Zorban62/EpromEmulator/Hardware/Scheda 2.jpg

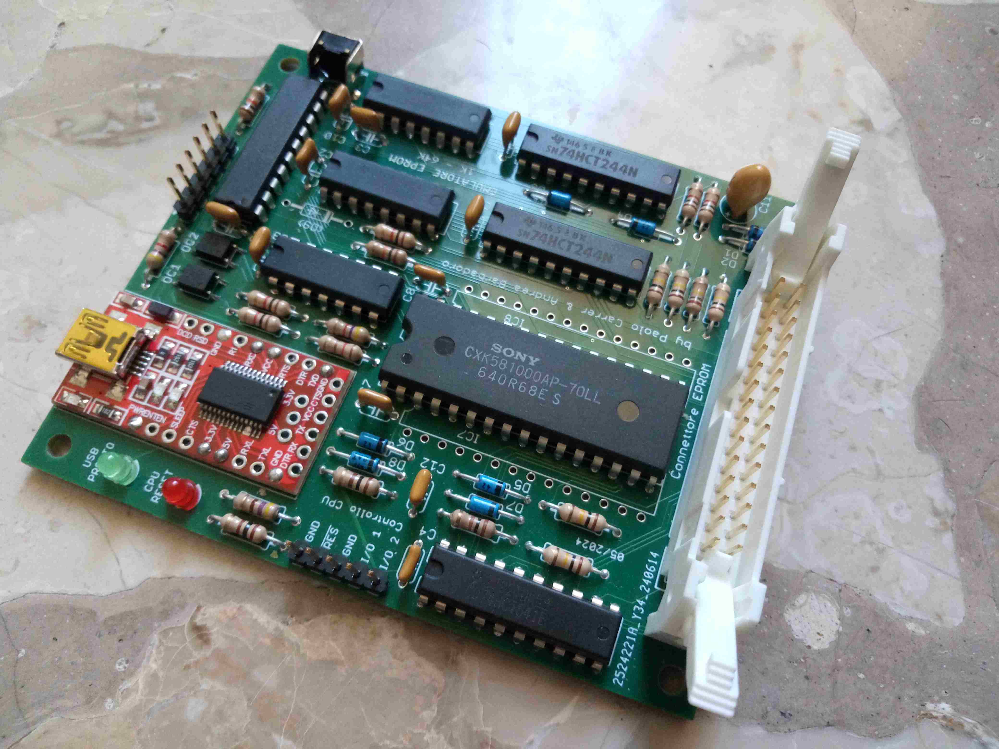
Hardware/Scheda 2.jpg
