Zorban62/EpromEmulator/Hardware/EMUL002.jpg

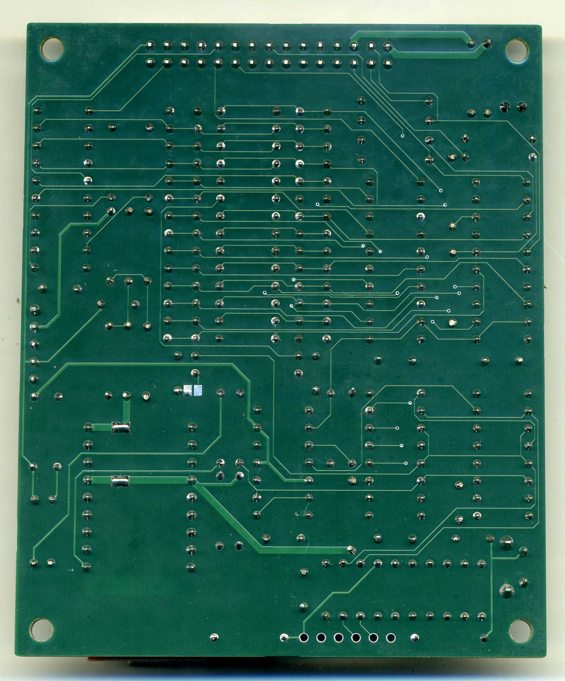
Hardware/EMUL002.jpg
