Zorban62/EpromEmulator/Hardware/Connettore crimpato filo Reset separato.jpg

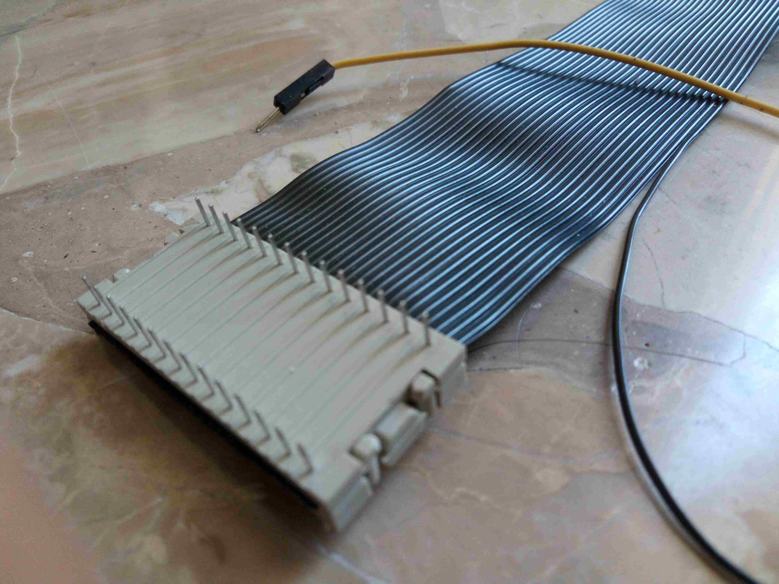
Hardware/Connettore crimpato filo Reset separato.jpg
