Zorban62/EpromEmulator/Hardware/Connettore DIL 28 pin.jpg

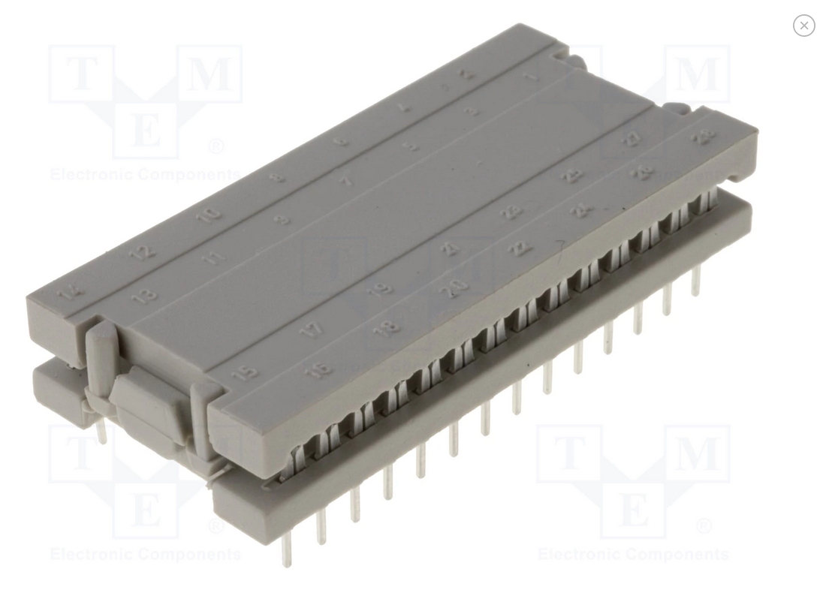
Hardware/Connettore DIL 28 pin.jpg
