Zorban62/EpromEmulator/Hardware/Connettore IDC 30 pin.jpg

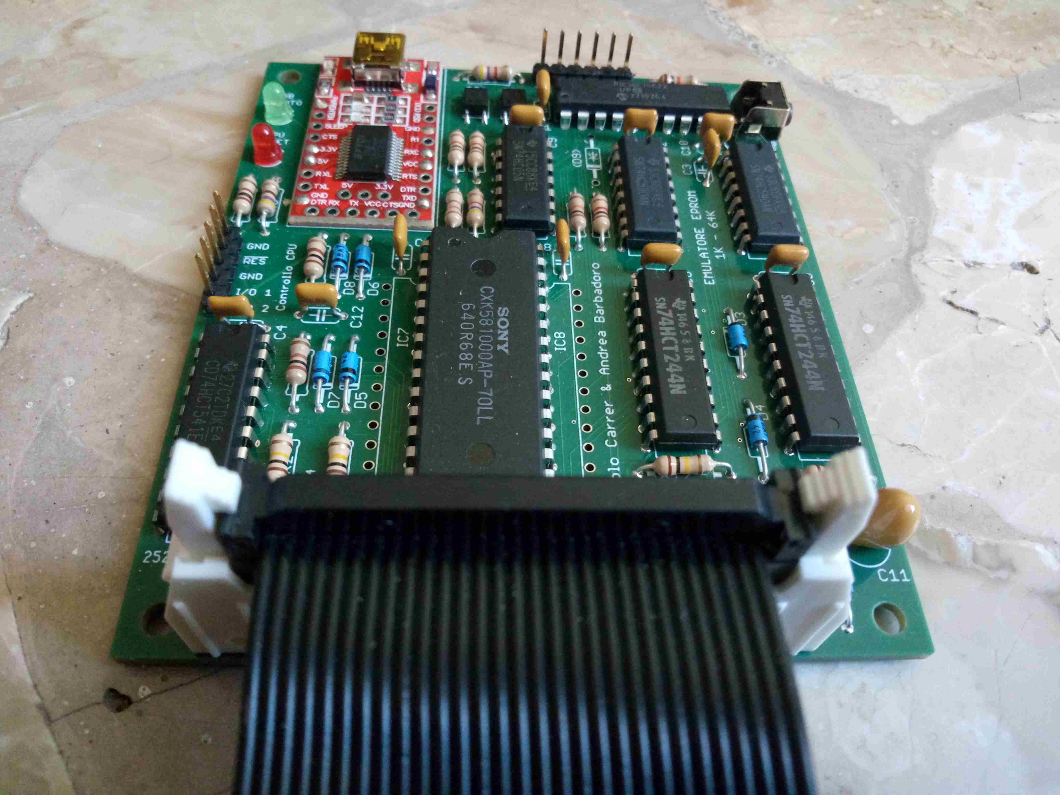
Hardware/Connettore IDC 30 pin.jpg
