Zorban62/EpromEmulator/Hardware/EMUL001.jpg

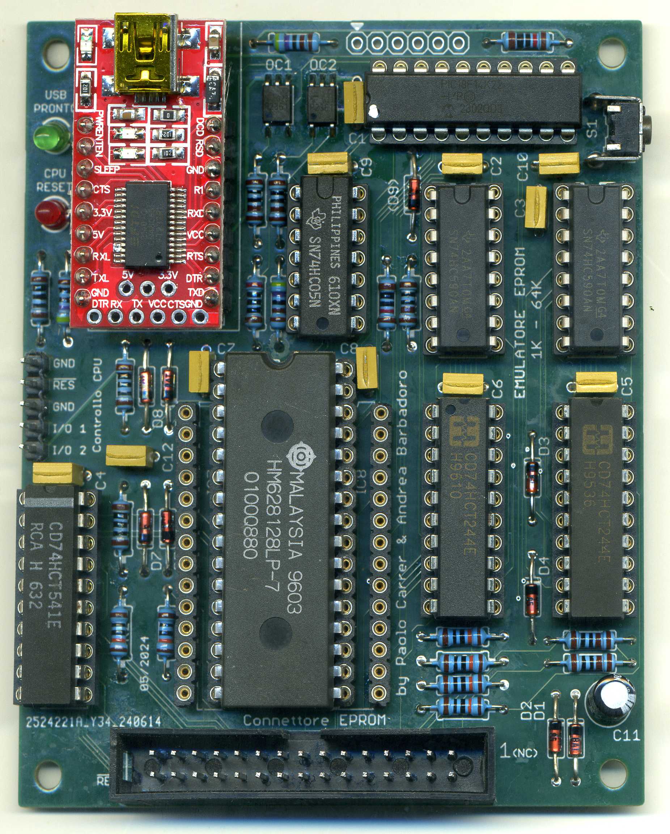
Hardware/EMUL001.jpg
