Zorban62/EpromEmulator/Hardware/PCB componenti.png

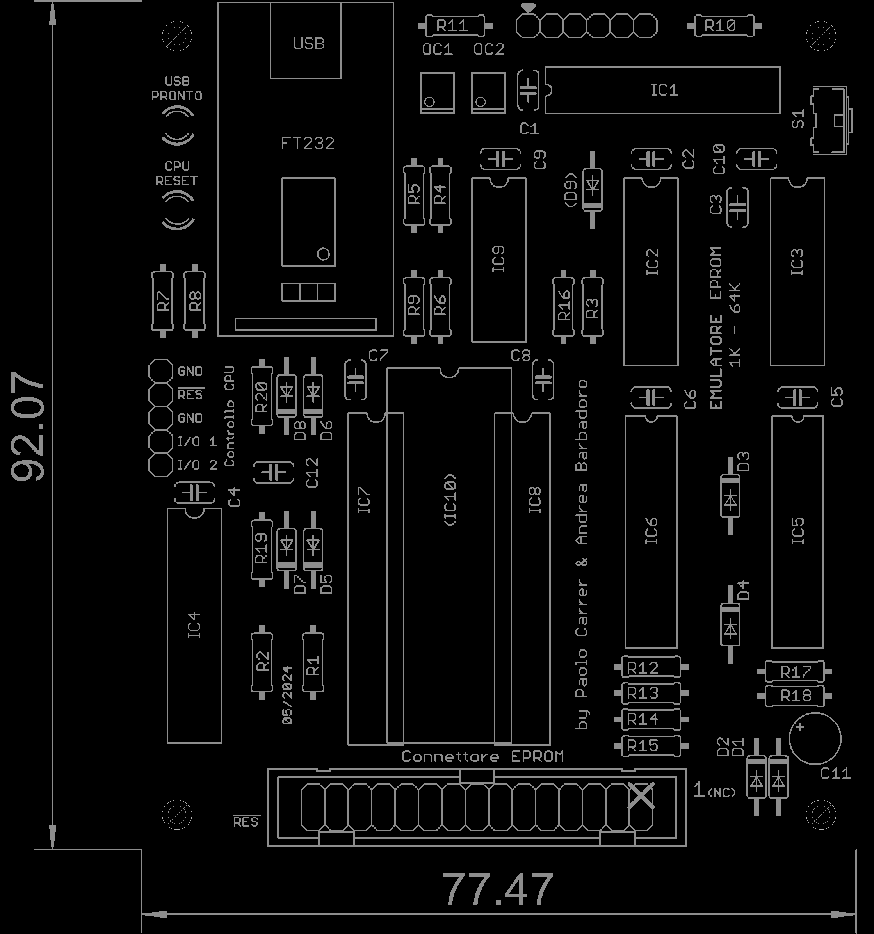
Hardware/PCB componenti.png
