Zorban62/EpromEmulator/Hardware/PCB rame BOTTOM.png

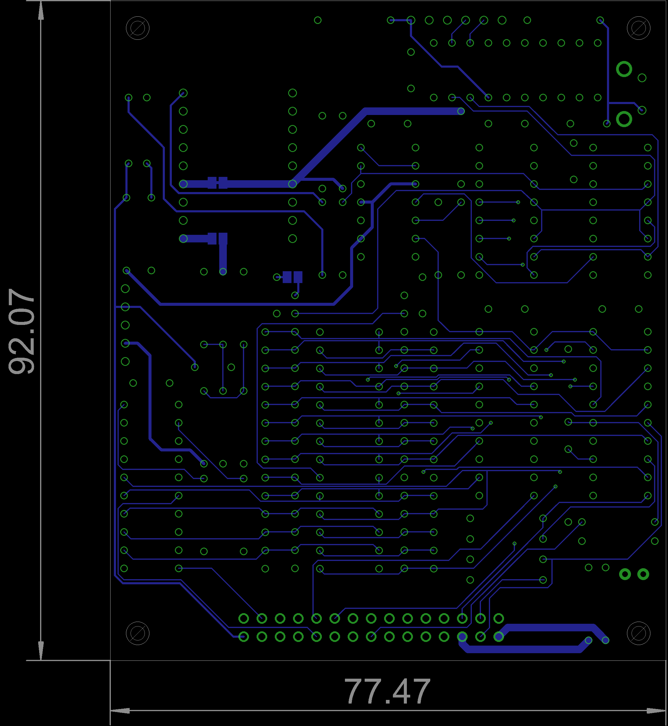
Hardware/PCB rame BOTTOM.png
