Zorban62/EpromEmulator/Hardware/PCB rame TOP.png

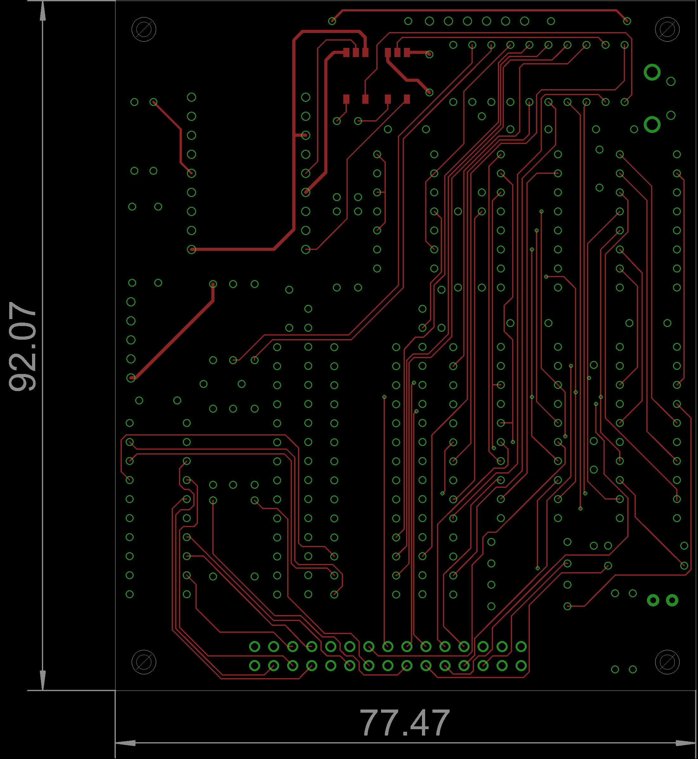
Hardware/PCB rame TOP.png
