Zorban62/EpromEmulator/Hardware/PCB valori.png

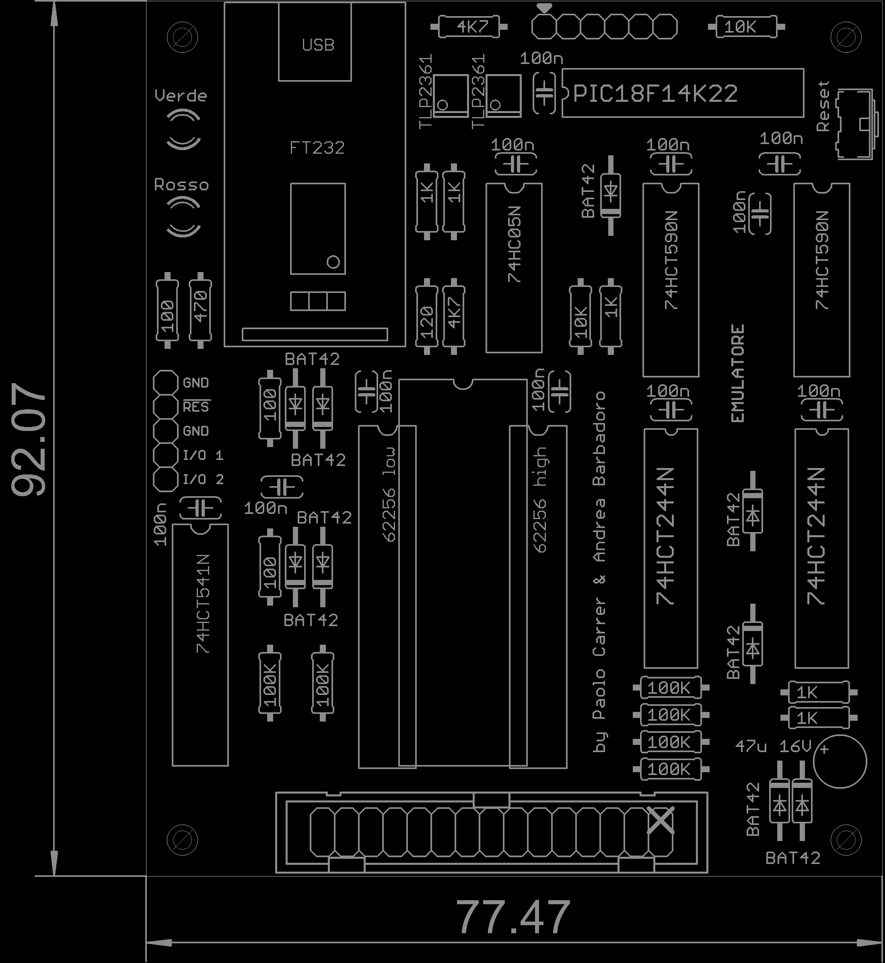
Hardware/PCB valori.png
