Zorban62/EpromEmulator/Hardware/schema 1.png

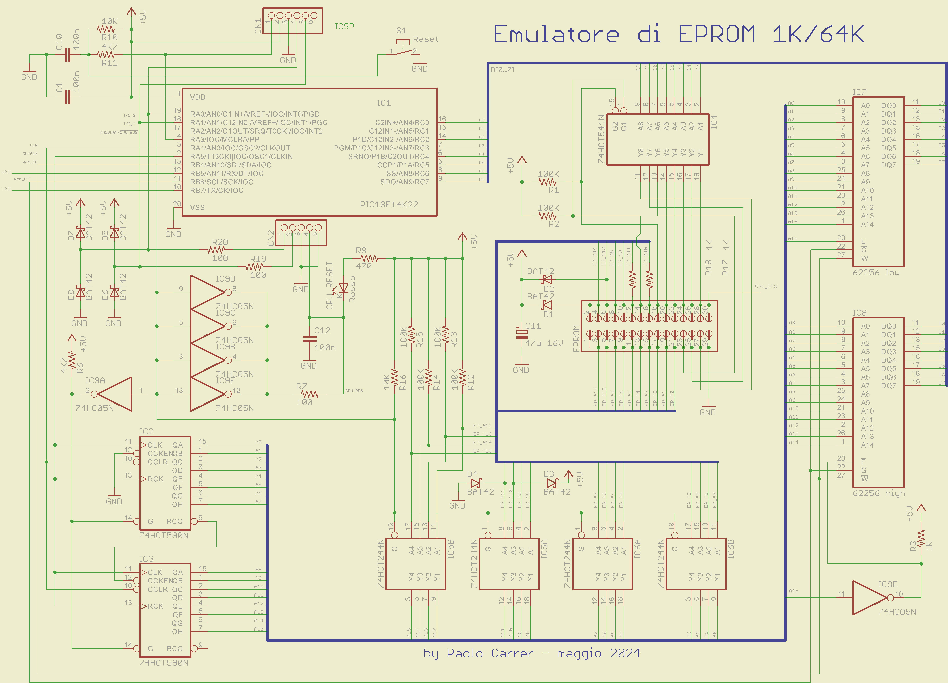
Hardware/schema 1.png
