Zorban62/EpromEmulator/Hardware/schema 2.png

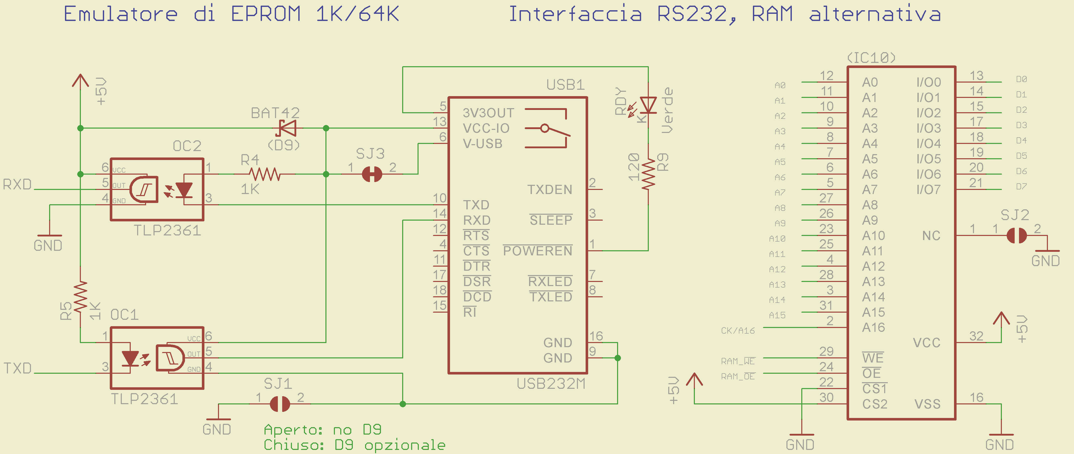
Hardware/schema 2.png
