Zorban62/EpromEmulator/Hardware/schema 3.png

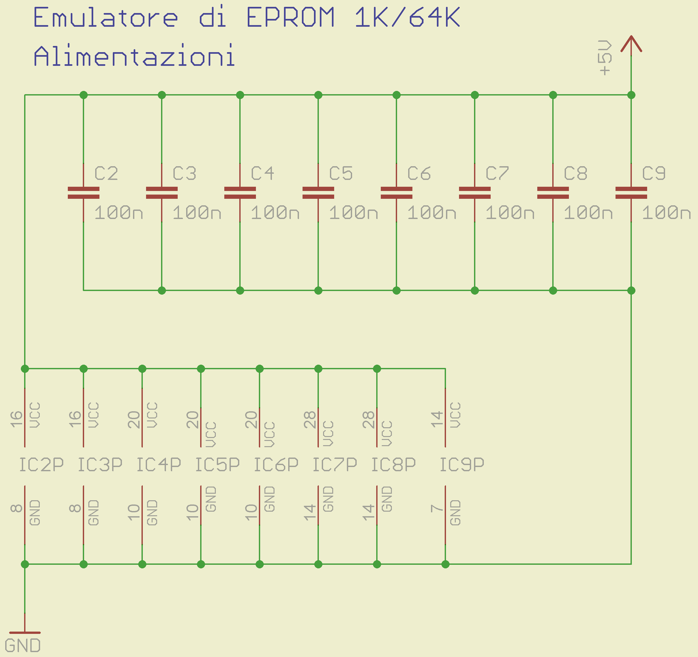
Hardware/schema 3.png
