Zorban62/EpromEmulator/Sorgenti Visual Studio/Parametri assembler.pdf

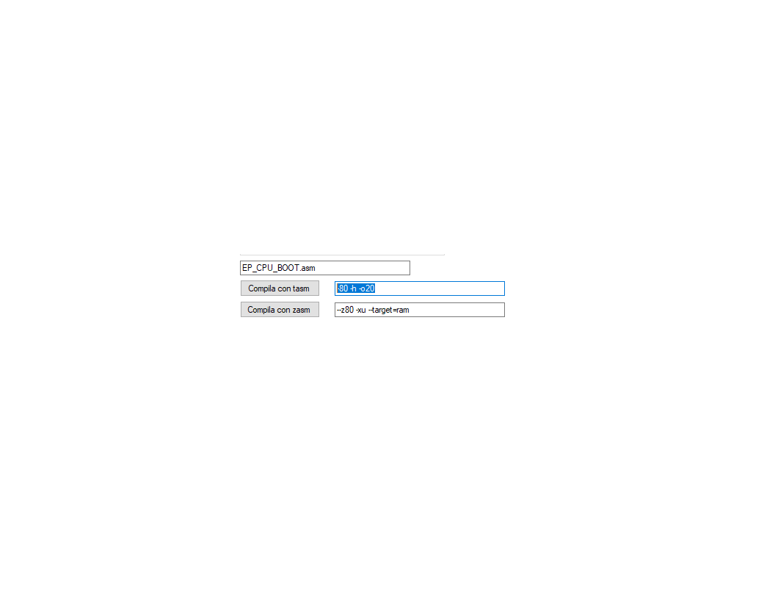
[picture p16: page 1]
