Zorban62/EpromEmulator/Firmware PIC/EEprom.asm

 
;******************************************************************************
; Banco EEPROM 0 padded
;******************************************************************************
                code    0xF00000

        de      0x01,0x02,0x03,0x00,0x00,0x00,0x00,0x00 ;00
        de      0x00,0x00,0x00,0x00,0x00,0x00,0x00,0x00 ;01
        de      0x00,0x00,0x00,0x00,0x00,0x00,0x00,0x00 ;02
        de      0x00,0x00,0x00,0x00,0x00,0x00,0x00,0x00 ;03
        de      0x00,0x00,0x00,0x00,0x00,0x00,0x00,0x00 ;04
        de      0x00,0x00,0x00,0x00,0x00,0x00,0x00,0x00 ;05
        de      0x00,0x00,0x00,0x00,0x00,0x00,0x00,0x00 ;06
        de      0x00,0x00,0x00,0x00,0x00,0x00,0x00,0x00 ;07
        de      0x00,0x00,0x00,0x00,0x00,0x00,0x00,0x00 ;08
        de      0x00,0x00,0x00,0x00,0x00,0x00,0x00,0x00 ;09
        de      0x00,0x00,0x00,0x00,0x00,0x00,0x00,0x00 ;0A
        de      0x00,0x00,0x00,0x00,0x00,0x00,0x00,0x00 ;0B
        de      0x00,0x00,0x00,0x00,0x00,0x00,0x00,0x00 ;0C
        de      0x00,0x00,0x00,0x00,0x00,0x00,0x00,0x00 ;0D
        de      0x00,0x00,0x00,0x00,0x00,0x00,0x00,0x00 ;0E
        de      0x00,0x00,0x00,0x00,0x00,0x00,0x00,0x00 ;0F
        de      0x00,0x00,0x00,0x00,0x00,0x00,0x00,0x00 ;10
        de      0x00,0x00,0x00,0x00,0x00,0x00,0x00,0x00 ;11
        de      0x00,0x00,0x00,0x00,0x00,0x00,0x00,0x00 ;12
        de      0x00,0x00,0x00,0x00,0x00,0x00,0x00,0x00 ;13
        de      0x00,0x00,0x00,0x00,0x00,0x00,0x00,0x00 ;14
        de      0x00,0x00,0x00,0x00,0x00,0x00,0x00,0x00 ;15
        de      0x00,0x00,0x00,0x00,0x00,0x00,0x00,0x00 ;16
        de      0x00,0x00,0x00,0x00,0x00,0x00,0x00,0x00 ;17
        de      0x00,0x00,0x00,0x00,0x00,0x00,0x00,0x00 ;18
        de      0x00,0x00,0x00,0x00,0x00,0x00,0x00,0x00 ;19
        de      0x00,0x00,0x00,0x00,0x00,0x00,0x00,0x00 ;1A
        de      0x00,0x00,0x00,0x00,0x00,0x00,0x00,0x00 ;1B
        de      0x00,0x00,0x00,0x00,0x00,0x00,0x00,0x00 ;1C
        de      0x00,0x00,0x00,0x00,0x00,0x00,0x00,0x00 ;1D
        de      0x00,0x00,0x00,0x00,0x00,0x00,0x00,0x00 ;1E
        de      0x00,0x00,0x00,0x00,0x00,0xFD,0xFE,0xFF ;1F

        end
