Zorban62/EpromEmulator/(commit log)

2024-09-01 Schema elettrico e gerber
2024-09-01 Schemi elettrici e Gerber
2024-09-01 Schemi elettrici e Gerber file
2024-09-01 Schemi elettrici, foto e Gerber file
